Modellbahn-Treff/Otter_WeichenBaustein/hardware/WeichenBaustein.kicad_pcb

## KiCad design hardware/WeichenBaustein.kicad_pcb (2026-10-18)

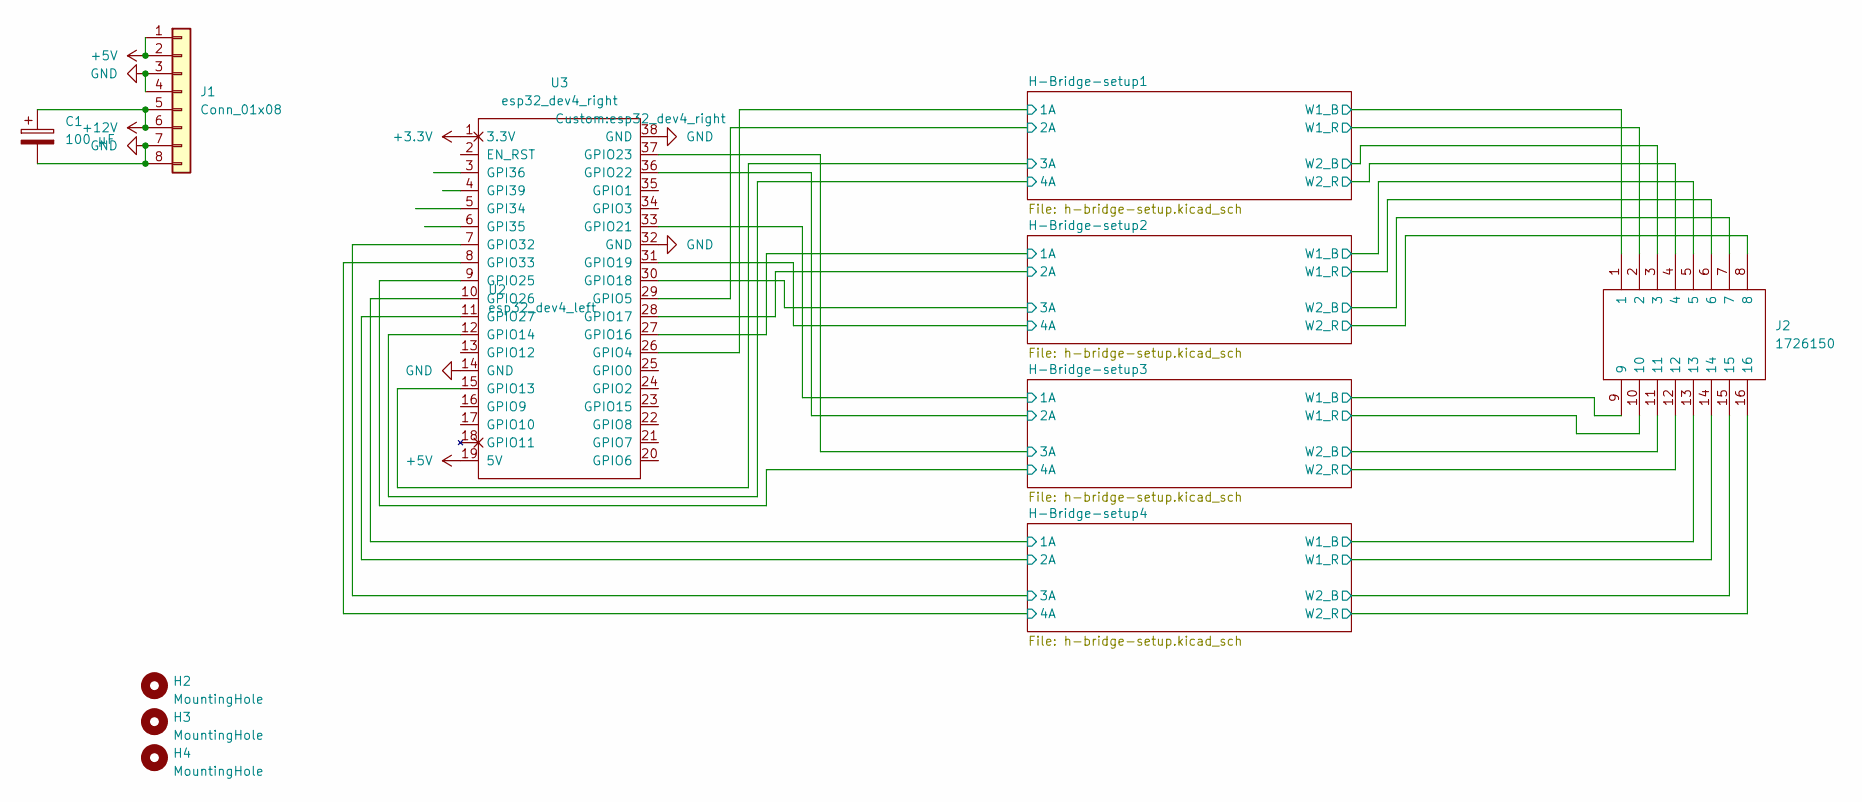
[picture p1: schematic WeichenBaustein.kicad_sch]

Parts:
C1: 100 µF; CP_Radial_D6.3mm_P2.50mm
H2, H3, H4: MountingHole; MountingHole_4.3mm_M4
J1: Conn_01x08; 1729186
J2: 1726150; Manufacturer_Part_Number 1726150; Mouser Part Number 651-1726150
U2: esp32_dev4_left; esp32_dev_left
U3: esp32_dev4_right

Connections:
+3.3V: U2.1 (3.3V)
+5V: J1.1, J1.2, U2.19 (5V); also elsewhere on the board
+12V: C1.1, J1.5, J1.6; also elsewhere on the board
/H-Bridge-setup1/1A: U3.26 (GPIO4); also elsewhere on the board
/H-Bridge-setup1/2A: U3.29 (GPIO5); also elsewhere on the board
/H-Bridge-setup1/3A: U2.15 (GPIO13); also elsewhere on the board
/H-Bridge-setup1/4A: U2.12 (GPIO14); also elsewhere on the board
/H-Bridge-setup1/W1_B: J2.1; also elsewhere on the board
/H-Bridge-setup1/W1_R: J2.2; also elsewhere on the board
/H-Bridge-setup1/W2_B: J2.3; also elsewhere on the board
/H-Bridge-setup1/W2_R: J2.4; also elsewhere on the board
/H-Bridge-setup2/1A: U3.27 (GPIO16); also elsewhere on the board
/H-Bridge-setup2/2A: U3.28 (GPIO17); also elsewhere on the board
/H-Bridge-setup2/3A: U3.30 (GPIO18); also elsewhere on the board
/H-Bridge-setup2/4A: U3.31 (GPIO19); also elsewhere on the board
/H-Bridge-setup2/W1_B: J2.5; also elsewhere on the board
/H-Bridge-setup2/W1_R: J2.6; also elsewhere on the board
/H-Bridge-setup2/W2_B: J2.7; also elsewhere on the board
/H-Bridge-setup2/W2_R: J2.8; also elsewhere on the board
/H-Bridge-setup3/1A: U3.33 (GPIO21); also elsewhere on the board
/H-Bridge-setup3/2A: U3.36 (GPIO22); also elsewhere on the board
/H-Bridge-setup3/3A: U3.37 (GPIO23); also elsewhere on the board
/H-Bridge-setup3/4A: U2.9 (GPIO25); also elsewhere on the board
/H-Bridge-setup3/W1_B: J2.9; also elsewhere on the board
/H-Bridge-setup3/W1_R: J2.10; also elsewhere on the board
/H-Bridge-setup3/W2_B: J2.11; also elsewhere on the board
/H-Bridge-setup3/W2_R: J2.12; also elsewhere on the board
/H-Bridge-setup4/1A: U2.10 (GPIO26); also elsewhere on the board
/H-Bridge-setup4/2A: U2.11 (GPIO27); also elsewhere on the board
/H-Bridge-setup4/3A: U2.7 (GPIO32); also elsewhere on the board
/H-Bridge-setup4/4A: U2.8 (GPIO33); also elsewhere on the board
/H-Bridge-setup4/W1_B: J2.13; also elsewhere on the board
/H-Bridge-setup4/W1_R: J2.14; also elsewhere on the board
/H-Bridge-setup4/W2_B: J2.15; also elsewhere on the board
/H-Bridge-setup4/W2_R: J2.16; also elsewhere on the board
GND: C1.2, J1.3, J1.4, J1.7, J1.8, U2.14 (GND), U3.32 (GND), U3.38 (GND); also elsewhere on the board

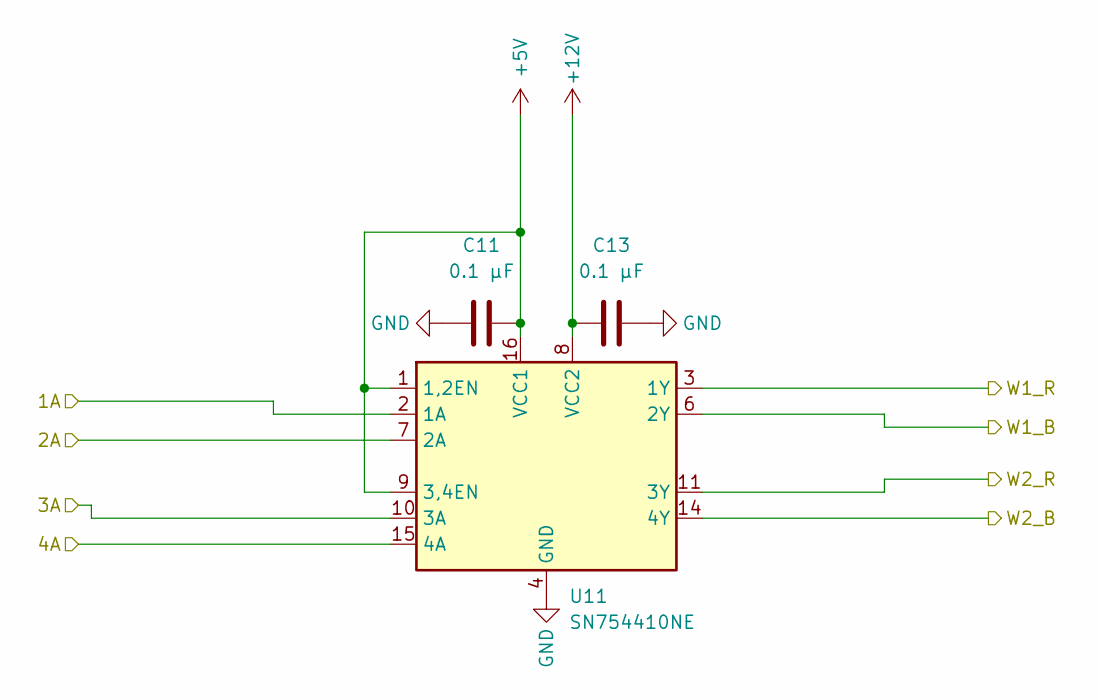
[picture p2: schematic h-bridge-setup.kicad_sch]

Parts:
C11, C13: 0.1 µF; C_0805_2012Metric_Pad1.18x1.45mm_HandSolder
U11: SN754410NE; DIP-16_W7.62mm

Connections:
+5V: C11.1, U11.1 (1,2EN), U11.9 (3,4EN), U11.16 (VCC1); also elsewhere on the board
+12V: C13.2, U11.8 (VCC2); also elsewhere on the board
/H-Bridge-setup1/1A: U11.2 (1A); also elsewhere on the board
/H-Bridge-setup1/2A: U11.7 (2A); also elsewhere on the board
/H-Bridge-setup1/3A: U11.10 (3A); also elsewhere on the board
/H-Bridge-setup1/4A: U11.15 (4A); also elsewhere on the board
/H-Bridge-setup1/W1_B: U11.6 (2Y); also elsewhere on the board
/H-Bridge-setup1/W1_R: U11.3 (1Y); also elsewhere on the board
/H-Bridge-setup1/W2_B: U11.14 (4Y); also elsewhere on the board
/H-Bridge-setup1/W2_R: U11.11 (3Y); also elsewhere on the board
GND: C11.2, C13.1, U11.4 (GND), U11.5 (GND), U11.12 (GND), U11.13 (GND); also elsewhere on the board

Parts of its further copies:
C21, C23, C31, C33, C41, C43: 0.1 µF; C_0805_2012Metric_Pad1.18x1.45mm_HandSolder
U21, U31, U41: SN754410NE; DIP-16_W7.62mm

Connections of its further copies:
+5V: C21.1, C31.1, C41.1, U21.1 (1,2EN), U21.9 (3,4EN), U21.16 (VCC1), U31.1 (1,2EN), U31.9 (3,4EN), U31.16 (VCC1), U41.1 (1,2EN), U41.9 (3,4EN), U41.16 (VCC1); also elsewhere on the board
+12V: C23.2, C33.2, C43.2, U21.8 (VCC2), U31.8 (VCC2), U41.8 (VCC2); also elsewhere on the board
/H-Bridge-setup2/1A: U21.2 (1A); also elsewhere on the board
/H-Bridge-setup2/2A: U21.7 (2A); also elsewhere on the board
/H-Bridge-setup2/3A: U21.10 (3A); also elsewhere on the board
/H-Bridge-setup2/4A: U21.15 (4A); also elsewhere on the board
/H-Bridge-setup2/W1_B: U21.6 (2Y); also elsewhere on the board
/H-Bridge-setup2/W1_R: U21.3 (1Y); also elsewhere on the board
/H-Bridge-setup2/W2_B: U21.14 (4Y); also elsewhere on the board
/H-Bridge-setup2/W2_R: U21.11 (3Y); also elsewhere on the board
/H-Bridge-setup3/1A: U31.2 (1A); also elsewhere on the board
/H-Bridge-setup3/2A: U31.7 (2A); also elsewhere on the board
/H-Bridge-setup3/3A: U31.10 (3A); also elsewhere on the board
/H-Bridge-setup3/4A: U31.15 (4A); also elsewhere on the board
/H-Bridge-setup3/W1_B: U31.6 (2Y); also elsewhere on the board
/H-Bridge-setup3/W1_R: U31.3 (1Y); also elsewhere on the board
/H-Bridge-setup3/W2_B: U31.14 (4Y); also elsewhere on the board
/H-Bridge-setup3/W2_R: U31.11 (3Y); also elsewhere on the board
/H-Bridge-setup4/1A: U41.2 (1A); also elsewhere on the board
/H-Bridge-setup4/2A: U41.7 (2A); also elsewhere on the board
/H-Bridge-setup4/3A: U41.10 (3A); also elsewhere on the board
/H-Bridge-setup4/4A: U41.15 (4A); also elsewhere on the board
/H-Bridge-setup4/W1_B: U41.6 (2Y); also elsewhere on the board
/H-Bridge-setup4/W1_R: U41.3 (1Y); also elsewhere on the board
/H-Bridge-setup4/W2_B: U41.14 (4Y); also elsewhere on the board
/H-Bridge-setup4/W2_R: U41.11 (3Y); also elsewhere on the board
GND: C21.2, C23.1, C31.2, C33.1, C41.2, C43.1, U21.4 (GND), U21.5 (GND), U21.12 (GND), U21.13 (GND), U31.4 (GND), U31.5 (GND), U31.12 (GND), U31.13 (GND), U41.4 (GND), U41.5 (GND), U41.12 (GND), U41.13 (GND); also elsewhere on the board

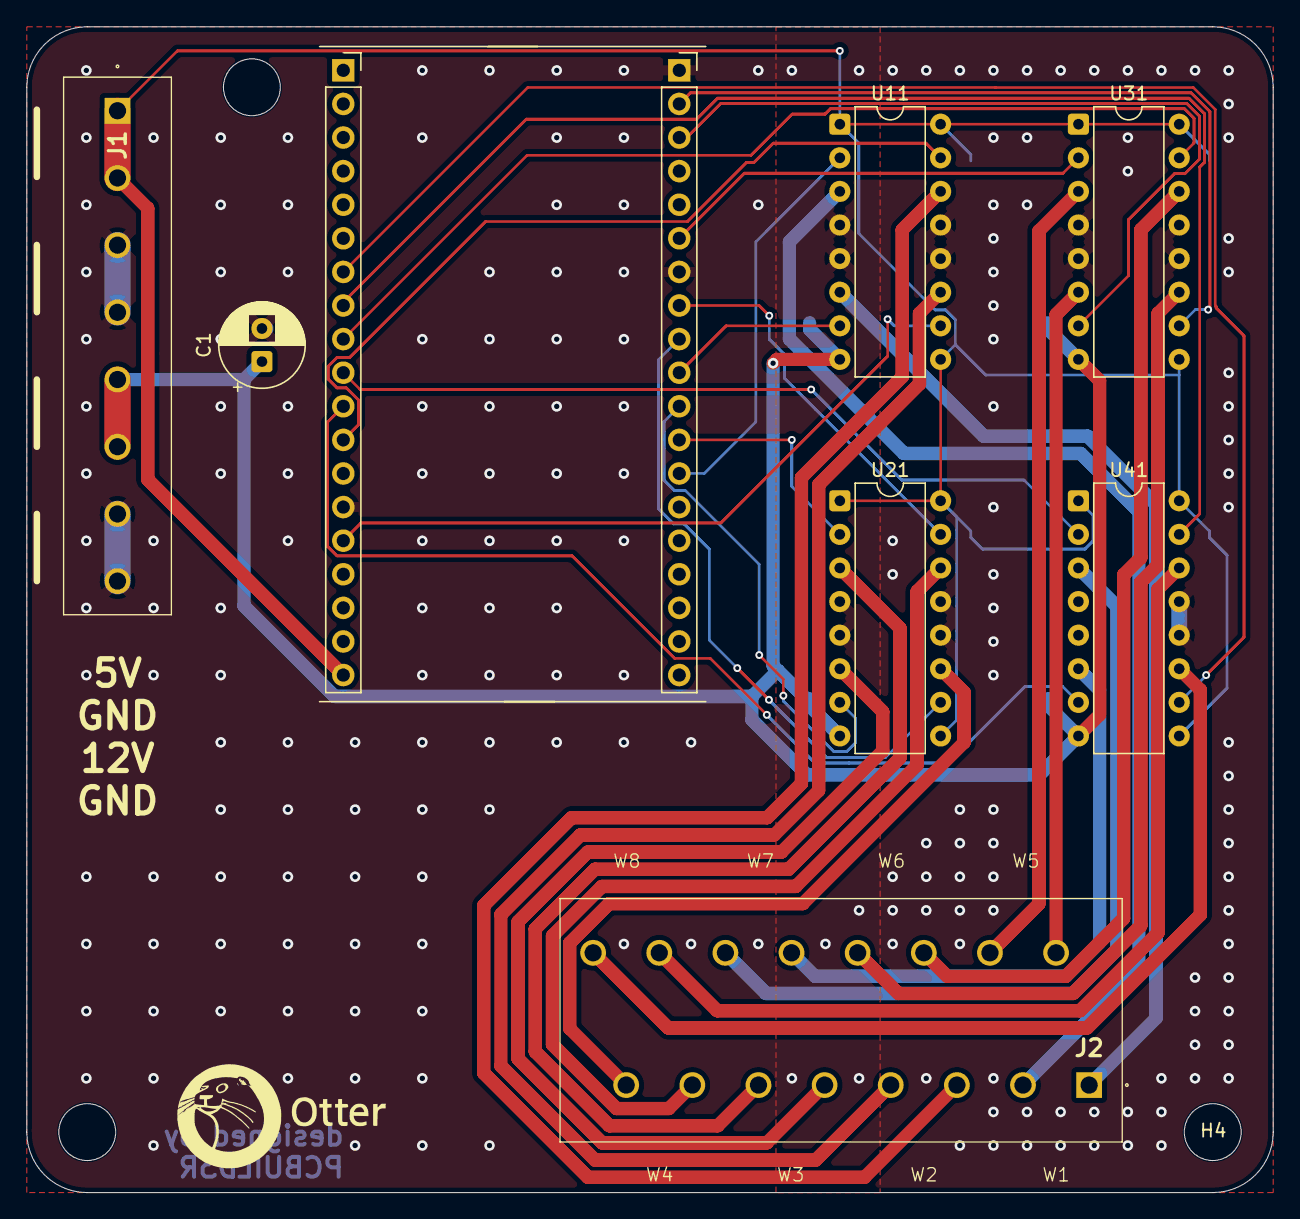
[picture p3: board WeichenBaustein.kicad_pcb from above]

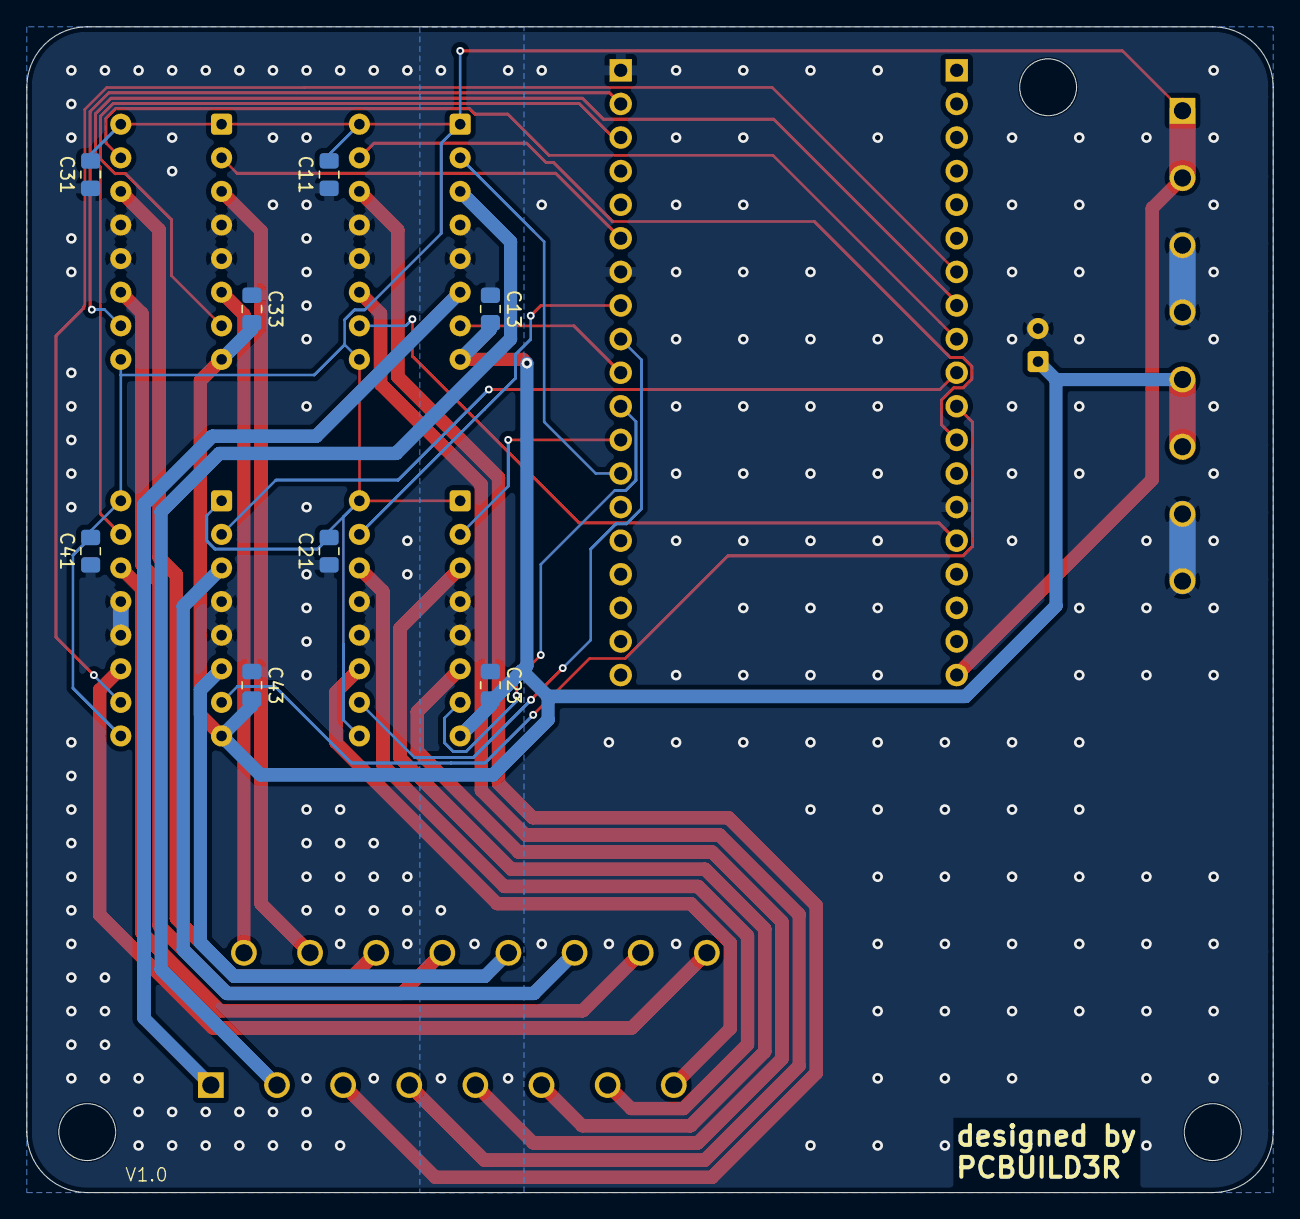
[picture p4: board WeichenBaustein.kicad_pcb from below]

Board: 2 copper layers, 94.2 x 88.1 mm, 20 parts (8 on the bottom side), 35 nets.
