Modellbahn-Treff/Otter_WeichenBaustein/(commit log)

2026-04-17 scematics and basic PCB layout
2026-10-18 Add initial web interface and manifest for Otter WeichenBaustein
    - Created index.html for the web interface, allowing users to flash firmware and configure WiFi settings directly from the browser.
    - Added manifest.json to define the application and its build configuration for the ESP32 chip.
    - Introduced NOTICE file to include third-party software licenses and attributions.
